Lc2007081623/departure-bell/蓝牙控制.md

# 安卓连接发车铃

固件设备名：**DepartureBell**。自锁开关保持ON、正在播放时可以连接；OFF播放警示后，功放关闭，蓝牙继续保持60秒，然后进入休眠、断开连接。期间可以调音量、选曲和保存，空闲时保存立即执行；这些命令不延长倒计时。再次ON立即恢复播放，下次OFF警示结束后重新计时60秒。冷启动开关OFF时也保留60秒连接窗口。

## 手机操作

1. 安装 Nordic 的 **nRF Connect for Mobile**：https://www.nordicsemi.com/Products/Development-tools/nRF-Connect-for-mobile 。打开蓝牙，并允许应用请求的附近设备权限；较旧安卓可能需要定位权限才能扫描。
2. 在 SCANNER 扫描，找到 DepartureBell，点击 CONNECT。
3. 展开服务 `c3b10000-7a6b-4c90-8d12-123456789abc`。
4. 对下面的 ACK 特征开启通知，再点击命令特征的写入按钮，格式选 **Text / UTF-8**，输入下表中的命令。使用 Write Request（有响应写入）。每次写一条。

| 命令 | 效果 |
| --- | --- |
| `V75` | 音量75%，默认值 |
| `V0` 到 `V100` | 音量0到100%，0为静音 |
| `T0` | 固定播放 etchujima |
| `T1` | 固定播放 inage-kaigan |
| `T2` | 固定播放 JK03-south |
| `T3` | 固定播放 JT03_SGW |
| `T4` | 固定播放 JT02_SMB（新增，11秒后为警示） |
| `T5` | 固定播放 takasaki（新增，17秒后为警示） |
| `R` | 从固定模式恢复随机，并重新随机选曲；已在随机模式则保持当前歌曲 |
| `S` | 保存发送此命令时的音量和选曲模式 |
| `?` | 更新状态 |

固定选曲在音乐播放时立即切换；警示播放时发送选曲命令，会等当前警示播完再使用新选择。手机控制不替代实体开关，OFF仍播放正在播放歌曲对应的警示音。

## 特征 UUID

| 特征 | UUID | 操作 |
| --- | --- | --- |
| 命令 | `c3b10001-7a6b-4c90-8d12-123456789abc` | 写入文本 |
| 状态 | `c3b10002-7a6b-4c90-8d12-123456789abc` | 读取、通知 |
| 曲目表 | `c3b10003-7a6b-4c90-8d12-123456789abc` | 读取 |
| ACK | `c3b10004-7a6b-4c90-8d12-123456789abc` | 读取、通知 |

正常命令回复例如 `OK:V75`；无效命令回复 `ERR:command`。保存先回复 `WAIT:S`，为避免Flash写入干扰声音，等音乐段结束或警示结束才写入，成功回复 `OK:S`。音乐循环最长24秒，保存时请等待成功再断电。

状态例子：`v75,mR,t0,pM,d0,s0`。
- v：音量；m：R随机、T固定。
- t：当前实际曲目编号，-1表示未播放；s：固定选曲设置编号。
- p：M音乐、W警示、I空闲、E错误。
- d：1表示设置与已保存值不同，0表示一致。

## 网页和电脑工具

`ble_control.html`提供连接、音量、曲目、保存按钮，电脑Chrome/Edge可打开使用。安卓Chrome的Web Bluetooth需要HTTPS页面；直接把本地HTML传到手机不保证可用。当前手机使用上面的nRF Connect方式，不需要部署网站。

电脑可运行 `.ble-tools\Scripts\python.exe ble_client.py V75 R S --wait 26`。`--test`读取设备曲目表，检查非法命令、音量、全部选曲和随机模式，完成后恢复测试前的设置，不主动保存。v1.1.0为六首，原来的0～3编号不变，新增4和5；请同时更新固件及安卓APK。

这是BLE控制连接，不支持手机蓝牙音频串流，也不支持无线更新固件。
