Lc2007081623/departure-bell/hardware/BOM_Board1_PCB1_2026-10-13.xlsx

No. | Quantity | Comment | Designator | Footprint | Value | Manufacturer Part | Manufacturer | Supplier Part | Supplier
1 | 1 | 100uF | C1 | C1206 | 100uF | CL31A107MQHNNNE | SAMSUNG(三星) | C15008 | LCSC
2 | 1 | 1uF | C2 | C1210 | 1uF | FS32X105K101EFG | PSA(信昌电陶) | C382212 | LCSC
3 | 3 | 22uF | C3,C5,C7 | C1206 | 22uF | HGC1206R5226M250NSPJ | Chinocera(华瓷) | C7432786 | LCSC
4 | 1 | 10uF | C4 | C0603 | 10uF | CL10A106KP8NNNC | SAMSUNG(三星) | C19702 | LCSC
5 | 1 | 100nF | C6 | C0805 | 100nF | FCC0805B104K500DT | FOJAN(富捷) | C5137467 | LCSC
6 | 1 | 100nF | C8 | C0603 | 100nF | FCC0603B104K500CT | FOJAN(富捷) | C5137636 | LCSC
7 | 3 | B2B-PH-K-S(LF)(SN) | CN4,CN5,CN6 | CONN-TH_B2B-PH-K-S |  | B2B-PH-K-S(LF)(SN) | JST | C131337 | LCSC
8 | 1 | SS54 | D1 | SMA_L4.3-W2.6-LS5.0-FD |  | SS54 | R+O(宏嘉诚) | C7420369 | LCSC
9 | 1 | 4.7uH | L2 | IND-SMD_L6.0-W6.0_FNR6020S | 4.7uH | FNR6045S4R7MT | cjiang(长江微电) | C168067 | LCSC
10 | 1 | 39kΩ | R1 | R0603 | 39kΩ | FRC0603F3902TS | FOJAN(富捷) | C2930098 | LCSC
11 | 1 | 110kΩ | R2 | R0603 | 110kΩ | FRC0603F1103TS | FOJAN(富捷) | C2906984 | LCSC
12 | 1 | 15kΩ | R3 | R0603 | 15kΩ | FRC0603F1502TS | FOJAN(富捷) | C2906995 | LCSC
13 | 2 | 100kΩ | R11,R13 | R0603 | 100kΩ | 0603WAF1003T5E | UNI-ROYAL(厚声) | C25803 | LCSC
14 | 1 | 1kΩ | R12 | R0603 | 1kΩ | 0603WAF1001T5E | UNI-ROYAL(厚声) | C21190 | LCSC
15 | 16 | Test-Point | TP1,TP2,TP3,TP4,TP5,TP6,TP7,TP8,TP9,TP10,TP11,TP12,TP13,TP14,TP15,TP16 | Test-Point-0.5mm
16 | 1 | NS4168 | U1 | ESOP-8_L4.9-W3.9-P1.27-LS6.0-BL-EP |  | NS4168 | Nsiway(纳芯威) | C910588 | LCSC
17 | 1 | FP6298XR-G1 | U2 | SOP-8_L4.9-W3.9-P1.27-LS6.0-BL-EP |  | FP6298XR-G1 | Advanced Analog Technology(类比) | C88319 | LCSC
