Lc2007081623/departure-bell/RELEASE_NOTES.md

# 发车铃 v1.1.0 · 六首曲库

- 新增 `JT02_SMB`：音乐0～11秒，之后为对应警示音。
- 新增 `takasaki`：音乐0～17秒，之后为对应警示音。
- 原四首编号0～3保持不变；新增编号4、5，兼容原有保存设置。
- 固件随机模式覆盖六首；安卓与网页新增选曲，BLE支持T0～T5。
- 12段音频通过解码、源文件哈希、CRC、响度和峰值检查；原四首编码数据保持不变。
- 保留75%默认音量、警示后BLE保持60秒及原有开关行为。

## 升级

请同时更新设备固件/音频和安卓APK。APK沿用原签名，版本码提高，可直接覆盖安装。固件包保持原4MB Flash分区，不清除NVS设置。硬件无需改动。

- `DepartureBell-1.1.0.apk`：安卓8及以上。
- `DepartureBell-firmware-1.1.0.zip`：包含应用、启动程序、分区表和六首音频。
- PCB的Gerber、BOM和接线说明保持不变，见仓库hardware目录及v1.0.0发布附件。
- 项目原创内容采用MIT；音乐和第三方组件保留各自权利。

构建及自动检查通过；已上传实物并通过启动CRC及六首BLE选曲、音量、随机模式检查，测试后恢复原音量和随机设置。新增曲目的实际试听和安卓手机验证待完成。
