Lc2007081623/departure-bell/(commit log)

2026-10-13 Add departure bell firmware and Android BLE controller
    [partitions.csv]
2026-10-13 Add v6 PCB Gerber and BOM production files
    [BOM_Board1_PCB1_2026-10-13.xlsx]
2026-10-14 Add JT02 SMB and Takasaki tracks with six-track firmware and Android 1.1
